conradbuck/winston-pomodoro/PCB-3D-render.png

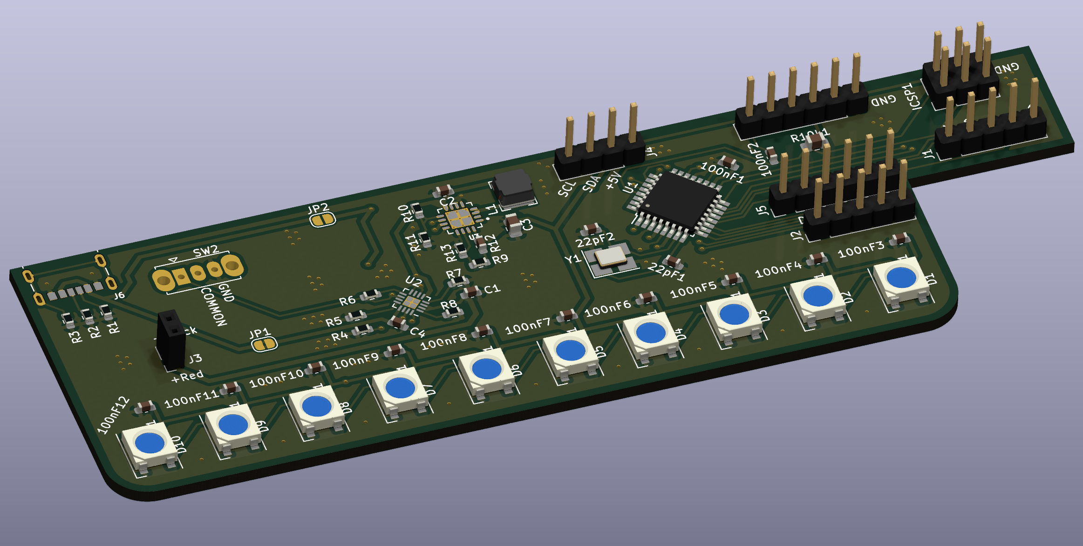
PCB-3D-render.png
