conradbuck/winston-pomodoro/winston-pomodoro-timer/firmware-flowchart.jpg

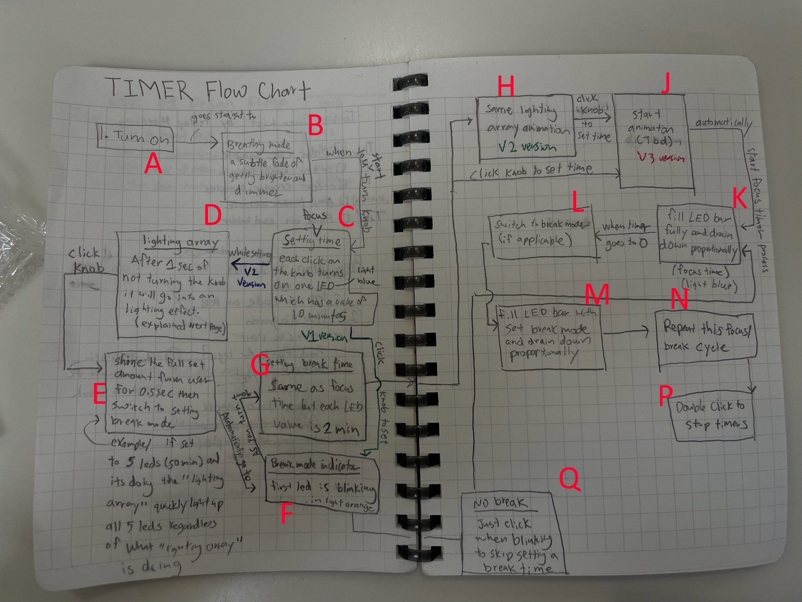
winston-pomodoro-timer/firmware-flowchart.jpg
