conradbuck/winston-pomodoro/PCB-layout-picture.png

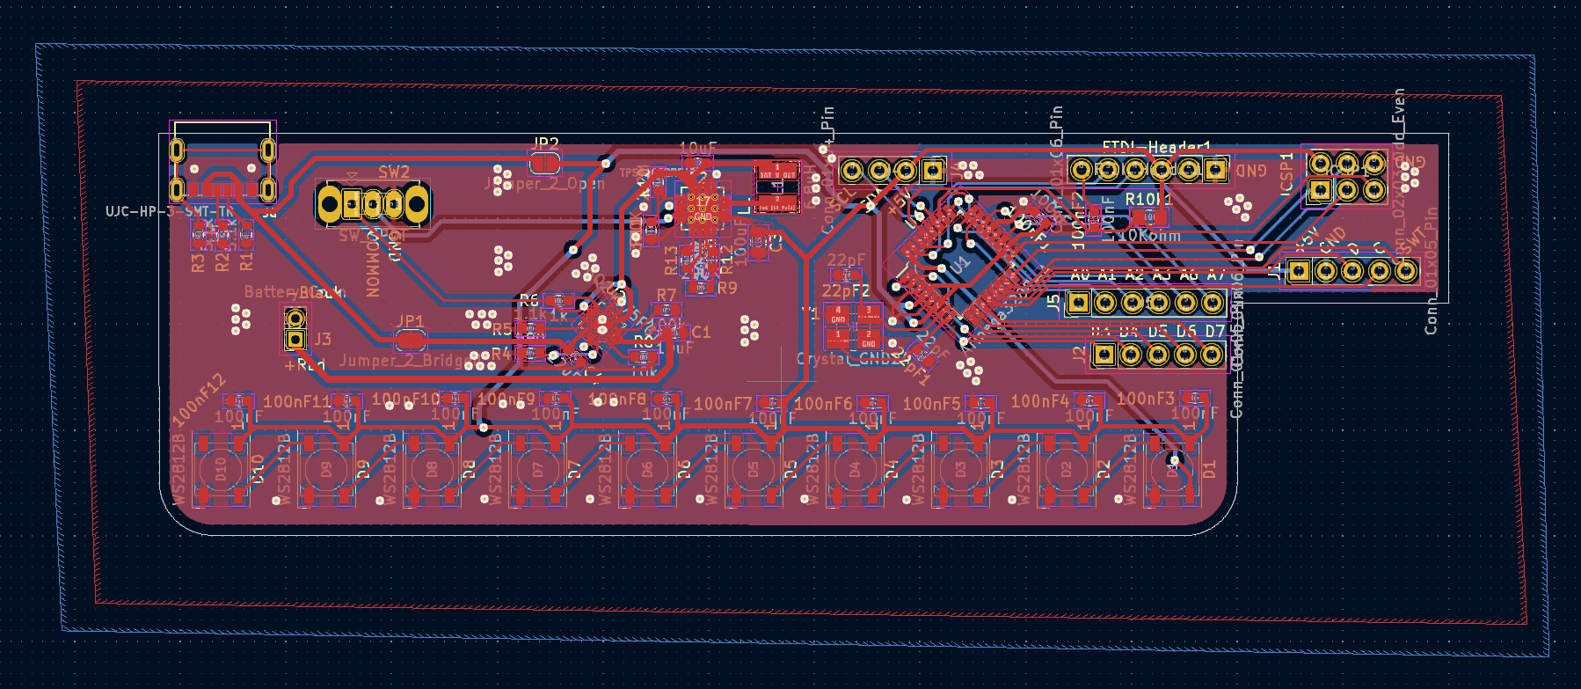
PCB-layout-picture.png
