conradbuck/winston-pomodoro/winston-pomodoro-timer/winston-pomodoro-timer.kicad_pcb

## KiCad design winston-pomodoro-timer/winston-pomodoro-timer.kicad_pcb (2024-12-01)

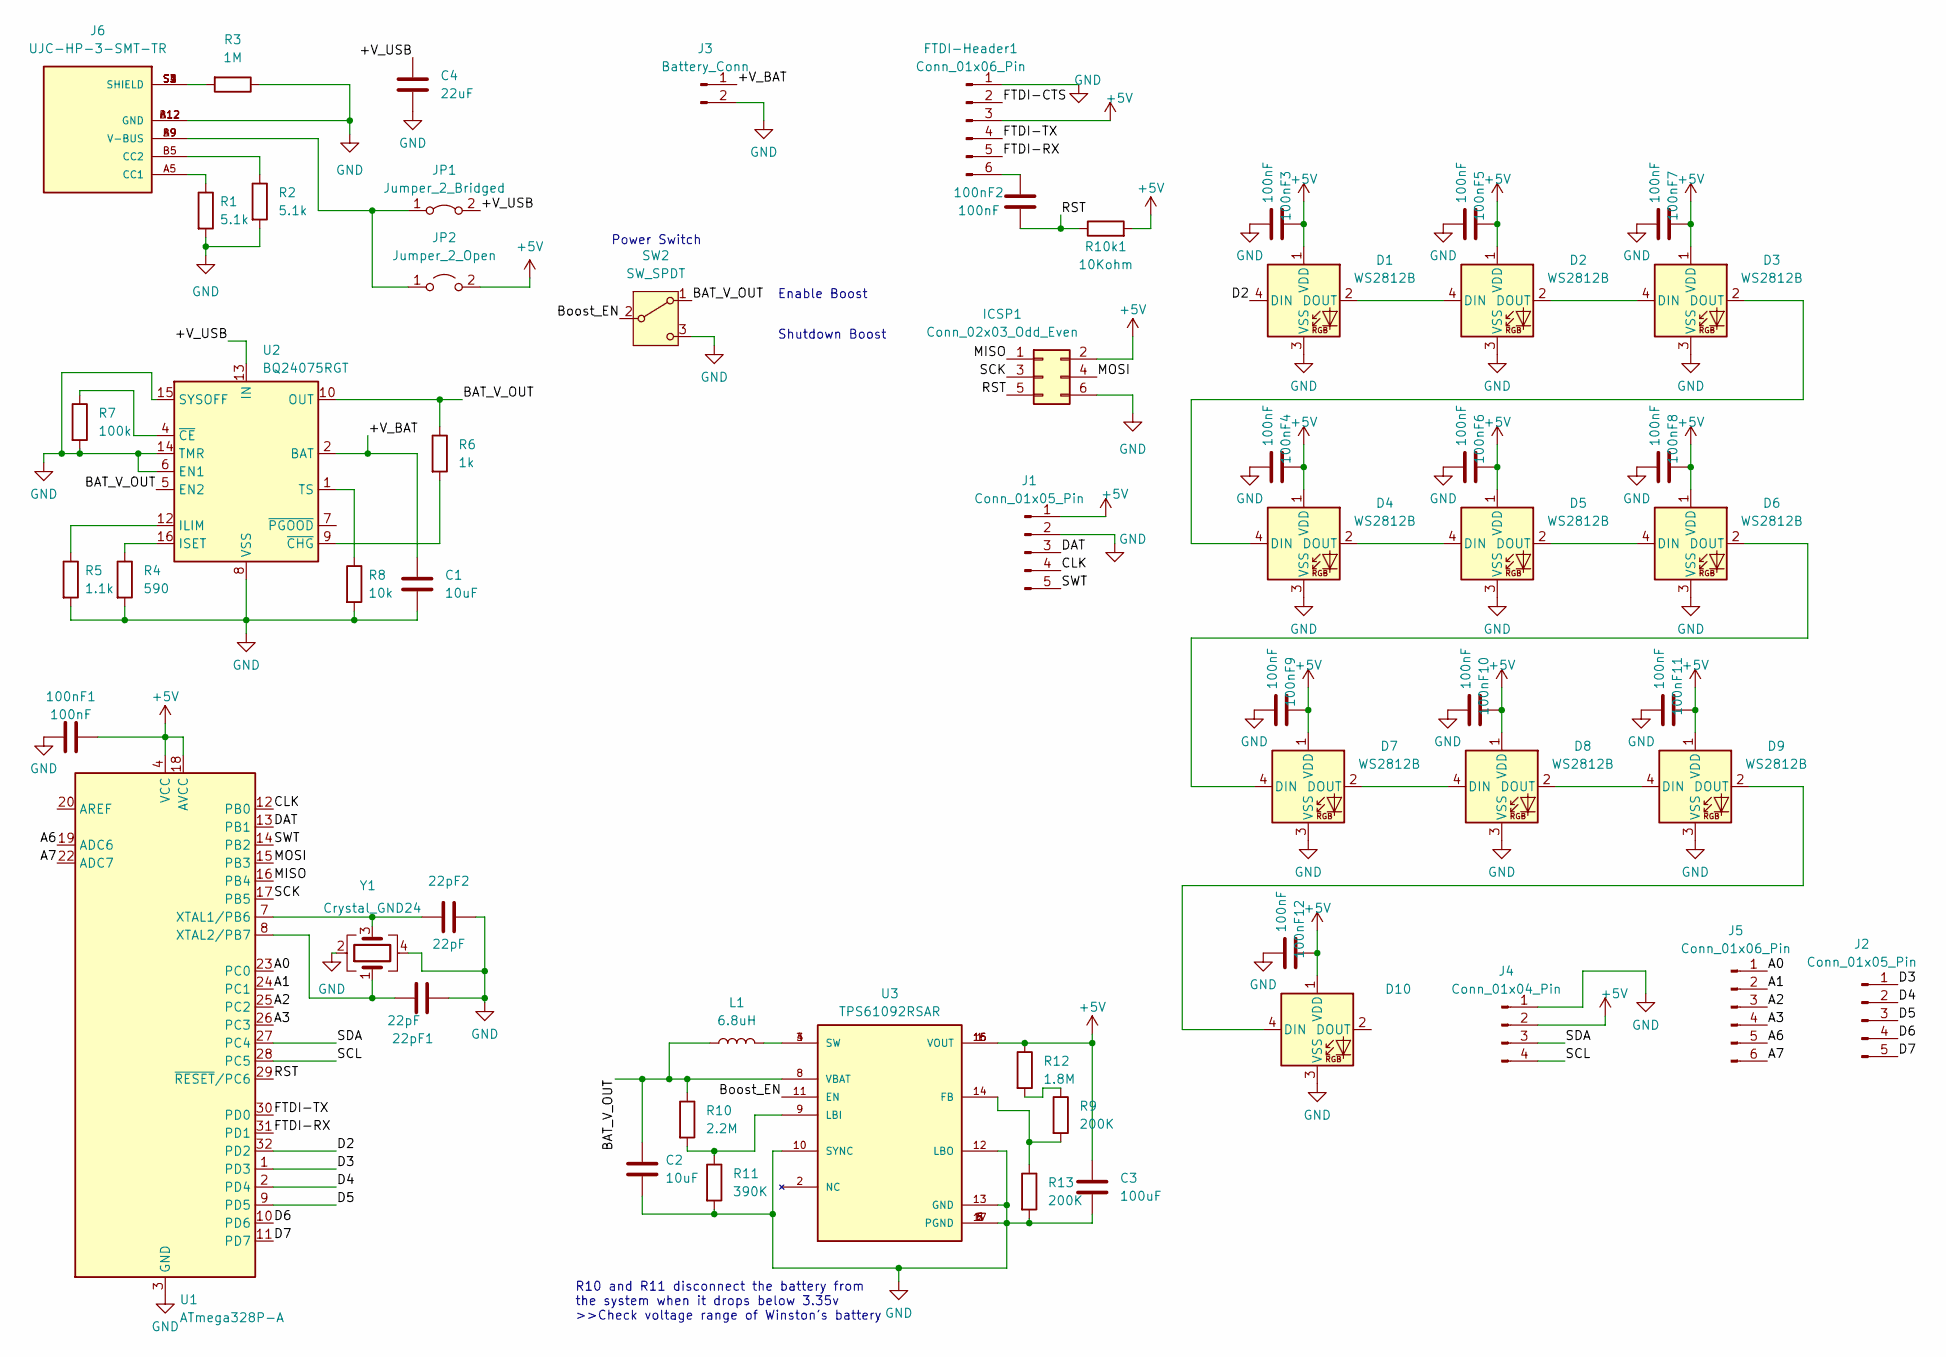
[picture p4: schematic winston-pomodoro-timer.kicad_sch]

Parts:
22pF1, 22pF2: 22pF; C_0603_1608Metric; LCSC C376875
100nF1: 100nF; C_0603_1608Metric; LCSC C2830721
100nF2, 100nF3, 100nF4, 100nF5, 100nF6, 100nF7, 100nF8, 100nF9, 100nF10, 100nF11, 100nF12: 100nF; C_0603_1608Metric
C1, C2: 10uF; C_0603_1608Metric
C3: 100uF; C_0805_2012Metric
C4: 22uF; C_0603_1608Metric
D1, D2, D3, D4, D5, D6, D7, D8, D9, D10: WS2812B; LED_WS2812B_PLCC4_5.0x5.0mm_P3.2mm
FTDI-Header1: Conn_01x06_Pin; PinHeader_1x06_P2.54mm_Vertical
ICSP1: Conn_02x03_Odd_Even; PinHeader_2x03_P2.54mm_Vertical
J1, J2: Conn_01x05_Pin; PinHeader_1x05_P2.54mm_Vertical
J3: Battery_Conn; PinSocket_1x02_P2.00mm_Vertical
J4: Conn_01x04_Pin; PinHeader_1x04_P2.54mm_Vertical
J5: Conn_01x06_Pin; PinHeader_1x06_P2.54mm_Vertical
J6: UJC-HP-3-SMT-TR; CUI_UJC-HP-3-SMT-TR; PARTREV 04/30/2020
JP1: Jumper_2_Bridged; SolderJumper-2_P1.3mm_Bridged2Bar_RoundedPad1.0x1.5mm
JP2: Jumper_2_Open; SolderJumper-2_P1.3mm_Open_RoundedPad1.0x1.5mm
L1: 6.8uH; L_Bourns-SRN4018
R1, R2: 5.1k; R_0603_1608Metric
R3: 1M; R_0603_1608Metric
R4: 590; R_0603_1608Metric
R5: 1.1k; R_0603_1608Metric
R6: 1k; R_0603_1608Metric
R7: 100k; R_0603_1608Metric
R8: 10k; R_0603_1608Metric
R9, R13: 200K; R_0603_1608Metric
R10: 2.2M; R_0603_1608Metric
R10k1: 10Kohm; C_0805_2012Metric_Pad1.18x1.45mm_HandSolder
R11: 390K; R_0603_1608Metric
R12: 1.8M; C_0603_1608Metric
SW2: SW_SPDT; SW_Slide_1P2T_CK_OS102011MS2Q
U1: ATmega328P-A; TQFP-32_7x7mm_P0.8mm; LCSC C132230
U2: BQ24075RGT; VQFN-16-1EP_3x3mm_P0.5mm_EP1.6x1.6mm
U3: TPS61092RSAR; CONV_TPS61092RSAR; PARTREV C
Y1: Crystal_GND24; Crystal_SMD_3225-4Pin_3.2x2.5mm_HandSoldering; LCSC C1985977

Connections:
+5V: 100nF1.1, 100nF3.2, 100nF4.2, 100nF5.2, 100nF6.2, 100nF7.2, 100nF8.2, 100nF9.2, 100nF10.2, 100nF11.2, 100nF12.2, C3.1, D1.1 (VDD), D2.1 (VDD), D3.1 (VDD), D4.1 (VDD), D5.1 (VDD), D6.1 (VDD), D7.1 (VDD), D8.1 (VDD), D9.1 (VDD), D10.1 (VDD), FTDI-Header1.3, ICSP1.2, J1.1, J4.2, JP2.2 (B), R10k1.2, R12.1, U1.4 (VCC), U1.6 (VCC), U1.18 (AVCC), U3.1 (VOUT), U3.15 (VOUT), U3.16 (VOUT)
/+V_BAT: C1.1, J3.1, U2.2 (BAT), U2.3 (BAT)
/+V_USB: C4.1, JP1.2 (B), U2.13 (IN)
/A0: J5.1, U1.23 (PC0)
/A1: J5.2, U1.24 (PC1)
/A2: J5.3, U1.25 (PC2)
/A3: J5.4, U1.26 (PC3)
/A6: J5.5, U1.19 (ADC6)
/A7: J5.6, U1.22 (ADC7)
/BAT_V_OUT: C2.1, L1.1, R6.1, R10.1, SW2.1 (A), U2.5 (EN2), U2.10 (OUT), U2.11 (OUT), U3.8 (VBAT)
/Boost_EN: SW2.2 (B), U3.11 (EN)
/CLK: J1.4, U1.12 (PB0)
/D2: D1.4 (DIN), U1.32 (PD2)
/D3: J2.1, U1.1 (PD3)
/D4: J2.2, U1.2 (PD4)
/D5: J2.3, U1.9 (PD5)
/D6: J2.4, U1.10 (PD6)
/D7: J2.5, U1.11 (PD7)
/DAT: J1.3, U1.13 (PB1)
/FTDI-CTS: FTDI-Header1.2
/FTDI-RX: FTDI-Header1.5, U1.31 (PD1)
/FTDI-TX: FTDI-Header1.4, U1.30 (PD0)
/MISO: ICSP1.1, U1.16 (PB4)
/MOSI: ICSP1.4, U1.15 (PB3)
/RST: 100nF2.1, ICSP1.5, R10k1.1, U1.29 (~RESET/PC6)
/SCK: ICSP1.3, U1.17 (PB5)
/SCL: J4.4, U1.28 (PC5)
/SDA: J4.3, U1.27 (PC4)
/SWT: J1.5, U1.14 (PB2)
GND: 22pF1.1, 22pF2.2, 100nF1.2, 100nF3.1, 100nF4.1, 100nF5.1, 100nF6.1, 100nF7.1, 100nF8.1, 100nF9.1, 100nF10.1, 100nF11.1, 100nF12.1, C1.2, C2.2, C3.2, C4.2, D1.3 (VSS), D2.3 (VSS), D3.3 (VSS), D4.3 (VSS), D5.3 (VSS), D6.3 (VSS), D7.3 (VSS), D8.3 (VSS), D9.3 (VSS), D10.3 (VSS), FTDI-Header1.1, ICSP1.6, J1.2, J3.2, J4.1, J6.A12 (GND), J6.B12 (GND), R1.2, R2.2, R3.1, R4.2, R5.2, R7.2, R8.2, R11.2, R13.2, SW2.3 (C), U1.3 (GND), U1.5 (GND), U1.21 (GND), U2.6 (EN1), U2.8 (VSS), U2.14 (TMR), U2.15 (SYSOFF), U2.17 (VSS), U3.5 (PGND), U3.6 (PGND), U3.7 (PGND), U3.10 (SYNC), U3.12 (LBO), U3.13 (GND), U3.17 (PGND), U3.18, U3.19, U3.20, U3.21, U3.22, U3.23, U3.24, U3.25, U3.26, Y1.2, Y1.4
unnamed: D1.2 (DOUT), D2.4 (DIN)
unnamed: D2.2 (DOUT), D3.4 (DIN)
unnamed: D3.2 (DOUT), D4.4 (DIN)
unnamed: D4.2 (DOUT), D5.4 (DIN)
unnamed: D5.2 (DOUT), D6.4 (DIN)
unnamed: D6.2 (DOUT), D7.4 (DIN)
unnamed: D7.2 (DOUT), D8.4 (DIN)
unnamed: D8.2 (DOUT), D9.4 (DIN)
unnamed: D9.2 (DOUT), D10.4 (DIN)
unnamed: 100nF2.2, FTDI-Header1.6
unnamed: J6.A5 (CC1), R1.1
unnamed: J6.B5 (CC2), R2.1
unnamed: J6.S1 (SHIELD), J6.S2 (SHIELD), J6.S3 (SHIELD), J6.S4 (SHIELD), R3.2
unnamed: J6.A9 (V-BUS), J6.B9 (V-BUS), JP1.1 (A), JP2.1 (A)
unnamed: L1.2, U3.3 (SW), U3.4 (SW)
unnamed: R9.1, R12.2
unnamed: 22pF2.1, U1.7 (XTAL1/PB6), Y1.3
unnamed: 22pF1.2, U1.8 (XTAL2/PB7), Y1.1
unnamed: R5.1, U2.12 (ILIM)
unnamed: R4.1, U2.16 (ISET)
unnamed: R8.1, U2.1 (TS)
unnamed: R7.1, U2.4 (~CE)
unnamed: R6.2, U2.9 (~CHG)
unnamed: R9.2, R13.1, U3.14 (FB)
unnamed: R10.2, R11.1, U3.9 (LBI)

Notes on the sheet:
Enable Boost
R10 and R11 disconnect the battery from the system when it drops below 3.35v >>Check voltage range of Winston's battery
Shutdown Boost
Power Switch

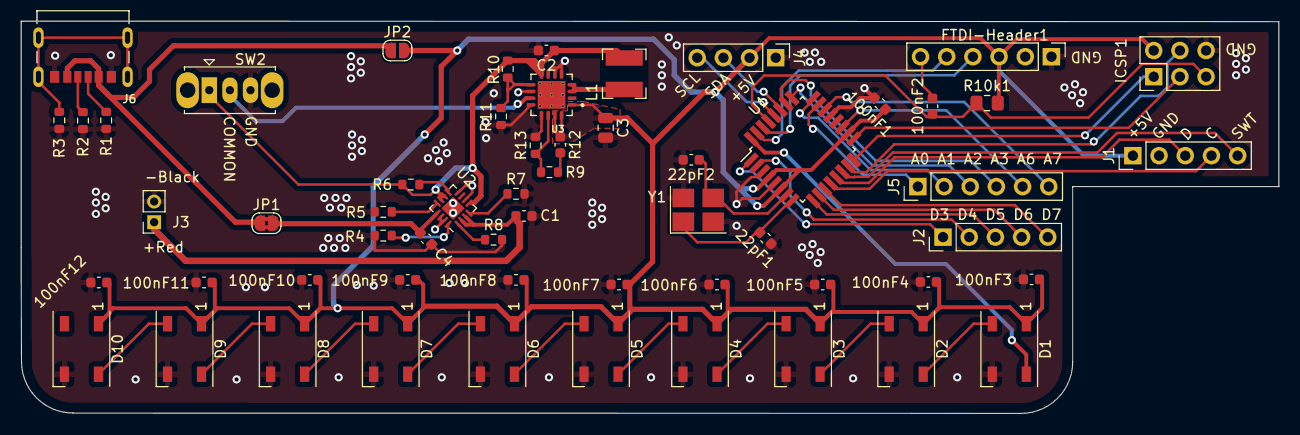
[picture p5: board winston-pomodoro-timer.kicad_pcb from above]

Board: 2 copper layers, 122.0 x 38.0 mm, 58 parts (0 on the bottom side), 54 nets.
