conradbuck/winston-pomodoro/winston-pomodoro-timer/arduino-config-filepath.txt

C:\Users\Computer\AppData\Local\Arduino15\packages\arduino\hardware\avr\1.8.6
