conradbuck/winston-pomodoro/(commit log)

2024-10-30 adding pcb to repo
    [winston-pomodoro-timer.kicad_pcb, winston-pomodoro-timer.kicad_sch]
2024-10-30 added special-parts.txt
    [winston-pomodoro-timer.kicad_pcb]
2024-11-01 added usbc port and started battery controller
    [winston-pomodoro-timer.kicad_sch]
2024-11-02 finished layout and routing
    [winston-pomodoro-timer.kicad_pcb, winston-pomodoro-timer.kicad_sch]
2024-11-03 added battery override jumpers
    [winston-pomodoro-timer.kicad_pcb, winston-pomodoro-timer.kicad_sch]
2024-11-03 added rounded corners
    [winston-pomodoro-timer.kicad_pcb]
2024-11-03 added manufacturing files
    [BOM-winston-pomodoro-timer.csv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]
2024-11-07 added kevins design feedback notes to special-parts
    [bom.csv, designators.csv, positions.csv, winston-pomodoro-timer.csv, winston-pomodoro-timer.kicad_pcb]
2024-11-07 added 3d model of pcb
2024-11-10 added rev2 pcb
    [winston-pomodoro-timer-rev2.csv, winston-pomodoro-timer-rev2.kicad_pcb, winston-pomodoro-timer-rev2.kicad_sch]
2024-11-11 added pictures of pcb for documentation
2024-11-17 added updated firmware and board config
2024-11-17 added board config
    [arduino-config-filepath.txt]
2024-11-17 added pin declarations
2024-11-23 case 6 nor 7 running despite CONSTANT state value in switch statement
2024-12-01 updated length of second in firmware-timer-if-chain <<< PROPER CODE
    [winston-pomodoro-timer.kicad_pcb]
2024-12-01 added flowchart and task organization
